mkilgore/avr-led-matrix/driver_board/led-matrix-headers.brd.png

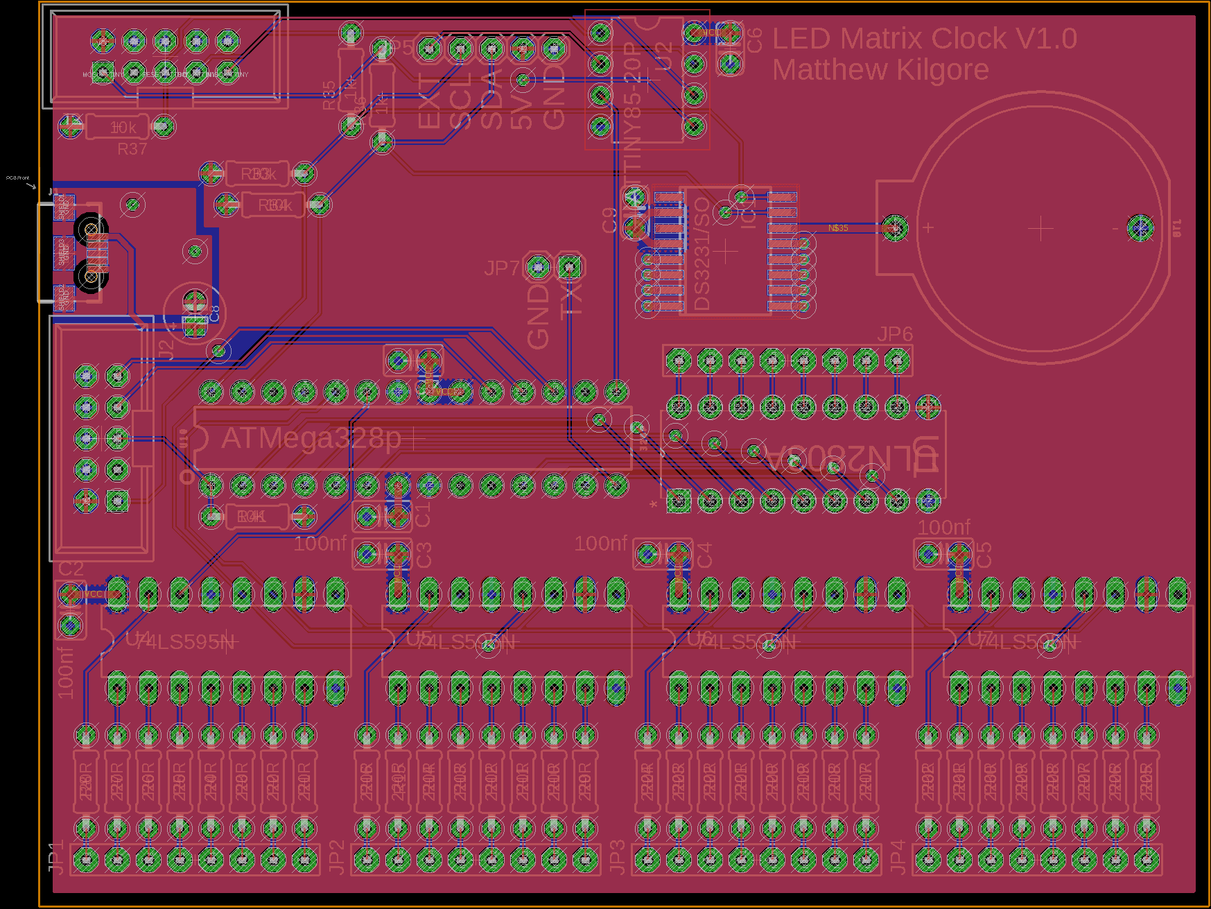
driver_board/led-matrix-headers.brd.png
