mkilgore/avr-led-matrix/driver_board/led-matrix-headers.sch.png

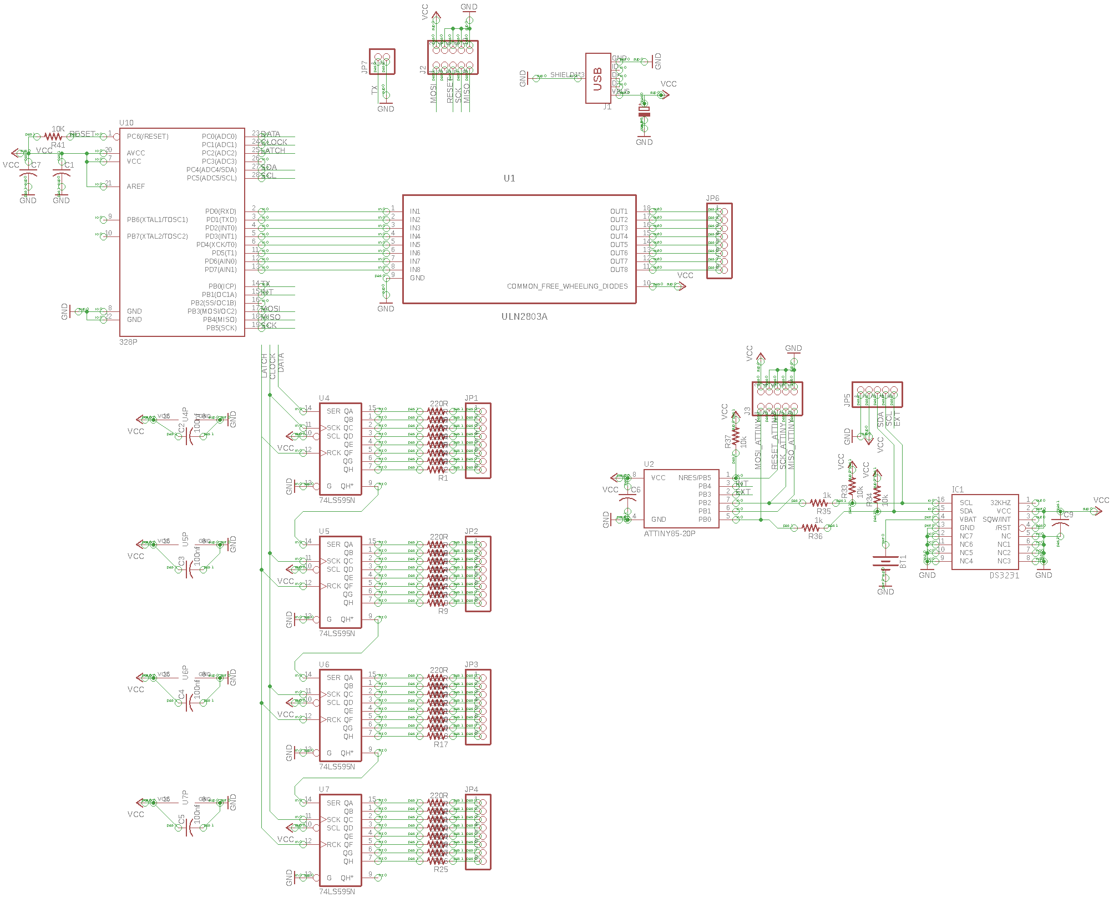
driver_board/led-matrix-headers.sch.png
