mkilgore/avr-led-matrix/driver_board/led-matrix-headers.brd

## EAGLE design driver_board/led-matrix-headers.brd (2018-10-06)

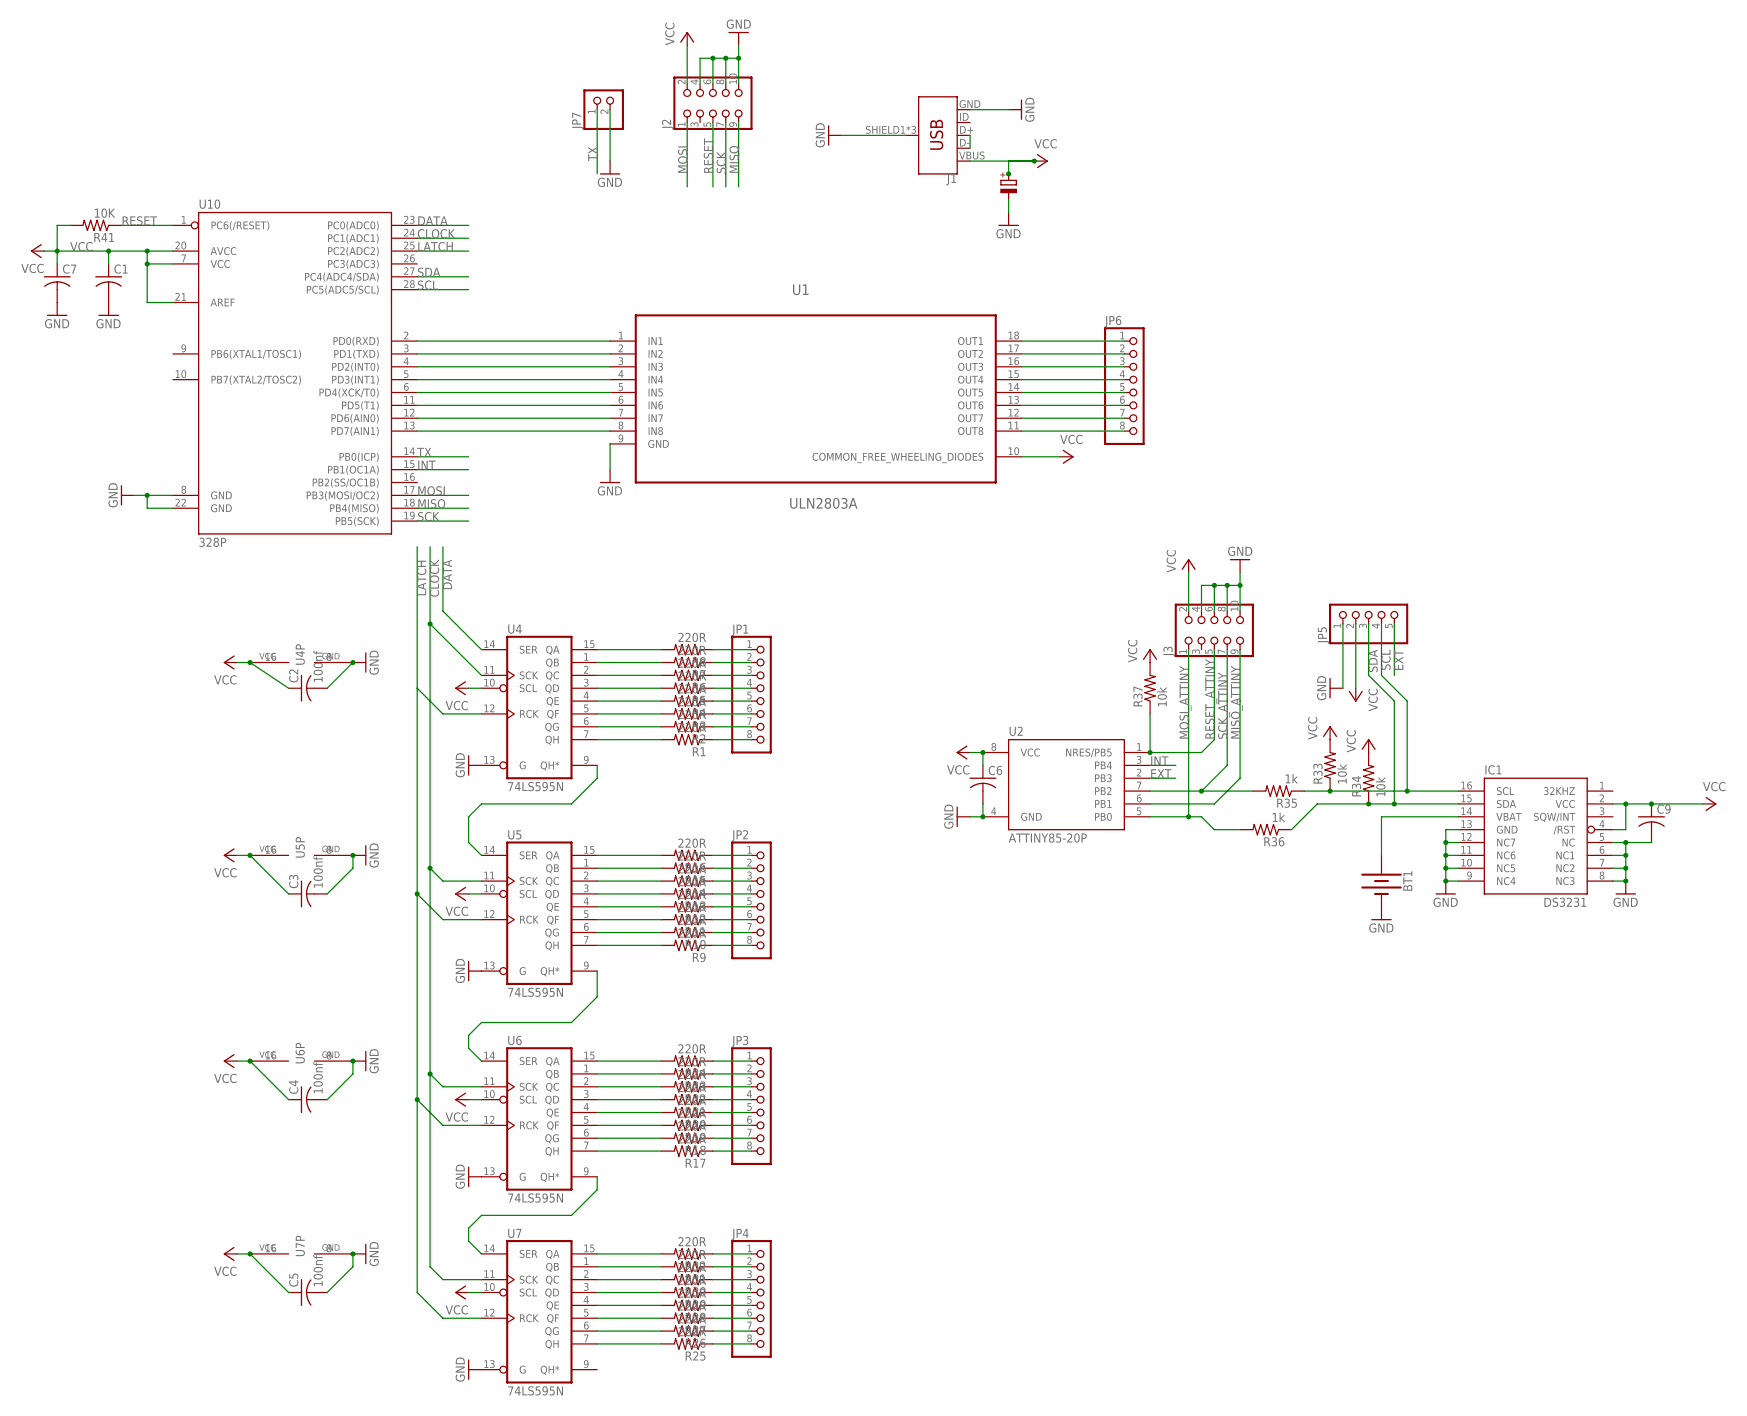
[picture p3: schematic led-matrix-headers.sch]

Parts:
BT1: BATTERY-20MM_PTH; BATTCOM_20MM_PTH
C1, C7: C-US025-025X050; C025-025X050
C2, C3, C4, C5: 100nf; C025-025X050
C6, C9: C-US025-024X044; C025-024X044
C8: 10U/35V; E2-5
IC1: DS3231/SO; SO16W
J1: USB_MICRO-B_FEMALE-SMT; USB-B-MICRO-SMD
J2, J3: CON_HEADER_2X05-PTH+SHROUDED_A; PINSHRD_PTH_2X05
JP1, JP2, JP3, JP4, JP6: PINHD-1X8BIG; 1X08-BIG
JP5: PINHD-1X5/OCT; 1X05/OCT
JP7: PINHD-1X02_2.54-S; 1X02-S
R1, R2, R3, R4, R5, R6, R7, R8, R9, R10, R11, R12, R13, R14, R15, R16, R17, R18, R19, R20, R21, R22, R23, R24, R25, R26, R27, R28, R29, R30, R31, R32: 220R; 0204/7
R33, R34, R37: 10k; 0204/7
R35, R36: 1k; 0204/7
R41: 10K; 0204/7
U1: ULN2803A; DIP254P762X393-18
U2: ATTINY85-20P; PDIP08_300MIL
U4, U5, U6, U7: 74LS595N; DIL16
U10: 328P; DIP28

Connections:
CLOCK: U4.11 (SCK), U5.11 (SCK), U6.11 (SCK), U7.11 (SCK), U10.24 (PC1(ADC1))
DATA: U4.14 (SER), U10.23 (PC0(ADC0))
EXT: JP5.5, U2.2 (PB3)
GND: BT1.2 (-), C1.2, C2.2, C3.2, C4.2, C5.2, C6.2, C7.2, C8.-, C9.2, IC1.5 (NC), IC1.6 (NC1), IC1.7 (NC2), IC1.8 (NC3), IC1.9 (NC4), IC1.10 (NC5), IC1.11 (NC6), IC1.12 (NC7), IC1.13 (GND), J1.GND, J1.SHIELD1 (SHIELD), J1.SHIELD2 (SHIELD), J1.SHIELD3 (SHIELD), J2.4, J2.6, J2.8, J2.10, J3.4, J3.6, J3.8, J3.10, JP5.1, JP7.2, U1.9 (GND), U2.4 (GND), U4.8 (GND), U4.13 (G), U5.8 (GND), U5.13 (G), U6.8 (GND), U6.13 (G), U7.8 (GND), U7.13 (G), U10.8 (GND), U10.22 (GND)
INT: U2.3 (PB4), U10.15 (PB1(OC1A))
LATCH: U4.12 (RCK), U5.12 (RCK), U6.12 (RCK), U7.12 (RCK), U10.25 (PC2(ADC2))
MISO: J2.9, U10.18 (PB4(MISO))
MISO_ATTINY: J3.9, U2.6 (PB1)
MOSI: J2.1, U10.17 (PB3(MOSI/OC2))
MOSI_ATTINY: J3.1, R36.2, U2.5 (PB0)
unnamed: JP1.8, R1.1
unnamed: JP1.7, R2.1
unnamed: JP1.6, R3.1
unnamed: JP1.5, R4.1
unnamed: JP1.4, R5.1
unnamed: JP1.3, R6.1
unnamed: JP1.2, R7.1
unnamed: JP1.1, R8.1
unnamed: JP2.8, R9.1
unnamed: JP2.7, R10.1
unnamed: JP2.6, R11.1
unnamed: JP2.5, R12.1
unnamed: JP2.4, R13.1
unnamed: JP2.3, R14.1
unnamed: JP2.2, R15.1
unnamed: JP2.1, R16.1
unnamed: JP3.8, R17.1
unnamed: JP3.7, R18.1
unnamed: JP3.6, R19.1
unnamed: JP3.5, R20.1
unnamed: JP3.4, R21.1
unnamed: JP3.3, R22.1
unnamed: JP3.2, R23.1
unnamed: JP3.1, R24.1
unnamed: JP4.8, R25.1
unnamed: JP4.7, R26.1
unnamed: JP4.6, R27.1
unnamed: JP4.5, R28.1
unnamed: JP4.4, R29.1
unnamed: JP4.3, R30.1
unnamed: JP4.2, R31.1
unnamed: JP4.1, R32.1
unnamed: BT1.1 (+), IC1.14 (VBAT)
unnamed: JP6.1, U1.18 (OUT1)
unnamed: JP6.2, U1.17 (OUT2)
unnamed: JP6.3, U1.16 (OUT3)
unnamed: JP6.4, U1.15 (OUT4)
unnamed: JP6.5, U1.14 (OUT5)
unnamed: JP6.6, U1.13 (OUT6)
unnamed: JP6.7, U1.12 (OUT7)
unnamed: JP6.8, U1.11 (OUT8)
unnamed: R1.2, U4.7 (QH)
unnamed: R2.2, U4.6 (QG)
unnamed: R3.2, U4.5 (QF)
unnamed: R4.2, U4.4 (QE)
unnamed: R5.2, U4.3 (QD)
unnamed: R6.2, U4.2 (QC)
unnamed: R7.2, U4.1 (QB)
unnamed: R8.2, U4.15 (QA)
unnamed: R25.2, U7.7 (QH)
unnamed: R26.2, U7.6 (QG)
unnamed: R27.2, U7.5 (QF)
unnamed: R28.2, U7.4 (QE)
unnamed: R29.2, U7.3 (QD)
unnamed: R30.2, U7.2 (QC)
unnamed: R31.2, U7.1 (QB)
unnamed: R32.2, U7.15 (QA)
unnamed: R17.2, U6.7 (QH)
unnamed: R18.2, U6.6 (QG)
unnamed: R19.2, U6.5 (QF)
unnamed: R20.2, U6.4 (QE)
unnamed: R21.2, U6.3 (QD)
unnamed: R22.2, U6.2 (QC)
unnamed: R23.2, U6.1 (QB)
unnamed: R24.2, U6.15 (QA)
unnamed: R9.2, U5.7 (QH)
unnamed: R10.2, U5.6 (QG)
unnamed: R11.2, U5.5 (QF)
unnamed: R12.2, U5.4 (QE)
unnamed: R13.2, U5.3 (QD)
unnamed: R14.2, U5.2 (QC)
unnamed: R15.2, U5.1 (QB)
unnamed: R16.2, U5.15 (QA)
unnamed: U4.9 (QH*), U5.14 (SER)
unnamed: U5.9 (QH*), U6.14 (SER)
unnamed: U6.9 (QH*), U7.14 (SER)
unnamed: U1.1 (IN1), U10.2 (PD0(RXD))
unnamed: U1.2 (IN2), U10.3 (PD1(TXD))
unnamed: U1.3 (IN3), U10.4 (PD2(INT0))
unnamed: U1.4 (IN4), U10.5 (PD3(INT1))
unnamed: U1.5 (IN5), U10.6 (PD4(XCK/T0))
unnamed: U1.6 (IN6), U10.11 (PD5(T1))
unnamed: U1.7 (IN7), U10.12 (PD6(AIN0))
unnamed: U1.8 (IN8), U10.13 (PD7(AIN1))
RESET: J2.5, R41.1, U10.1 (PC6(/RESET))
RESET_ATTINY: J3.5, R37.1, U2.1 (NRES/PB5)
SCK: J2.7, U10.19 (PB5(SCK))
SCK_ATTINY: J3.7, R35.2, U2.7 (PB2)
SCL: IC1.16 (SCL), JP5.4, R33.1, R35.1, U10.28 (PC5(ADC5/SCL))
SDA: IC1.15 (SDA), JP5.3, R34.1, R36.1, U10.27 (PC4(ADC4/SDA))
TX: JP7.1, U10.14 (PB0(ICP))
USB-DATA: J1.D+, J1.D-
VCC: C1.1, C2.1, C3.1, C4.1, C5.1, C6.1, C7.1, C8.+, C9.1, IC1.2 (VCC), IC1.4 (/RST), J1.VBUS, J2.2, J3.2, JP5.2, R33.2, R34.2, R37.2, R41.2, U1.10 (COMMON_FREE_WHEELING_DIODES), U2.8 (VCC), U4.10 (SCL), U4.16 (VCC), U5.10 (SCL), U5.16 (VCC), U6.10 (SCL), U6.16 (VCC), U7.10 (SCL), U7.16 (VCC), U10.7 (VCC), U10.20 (AVCC), U10.21 (AREF)

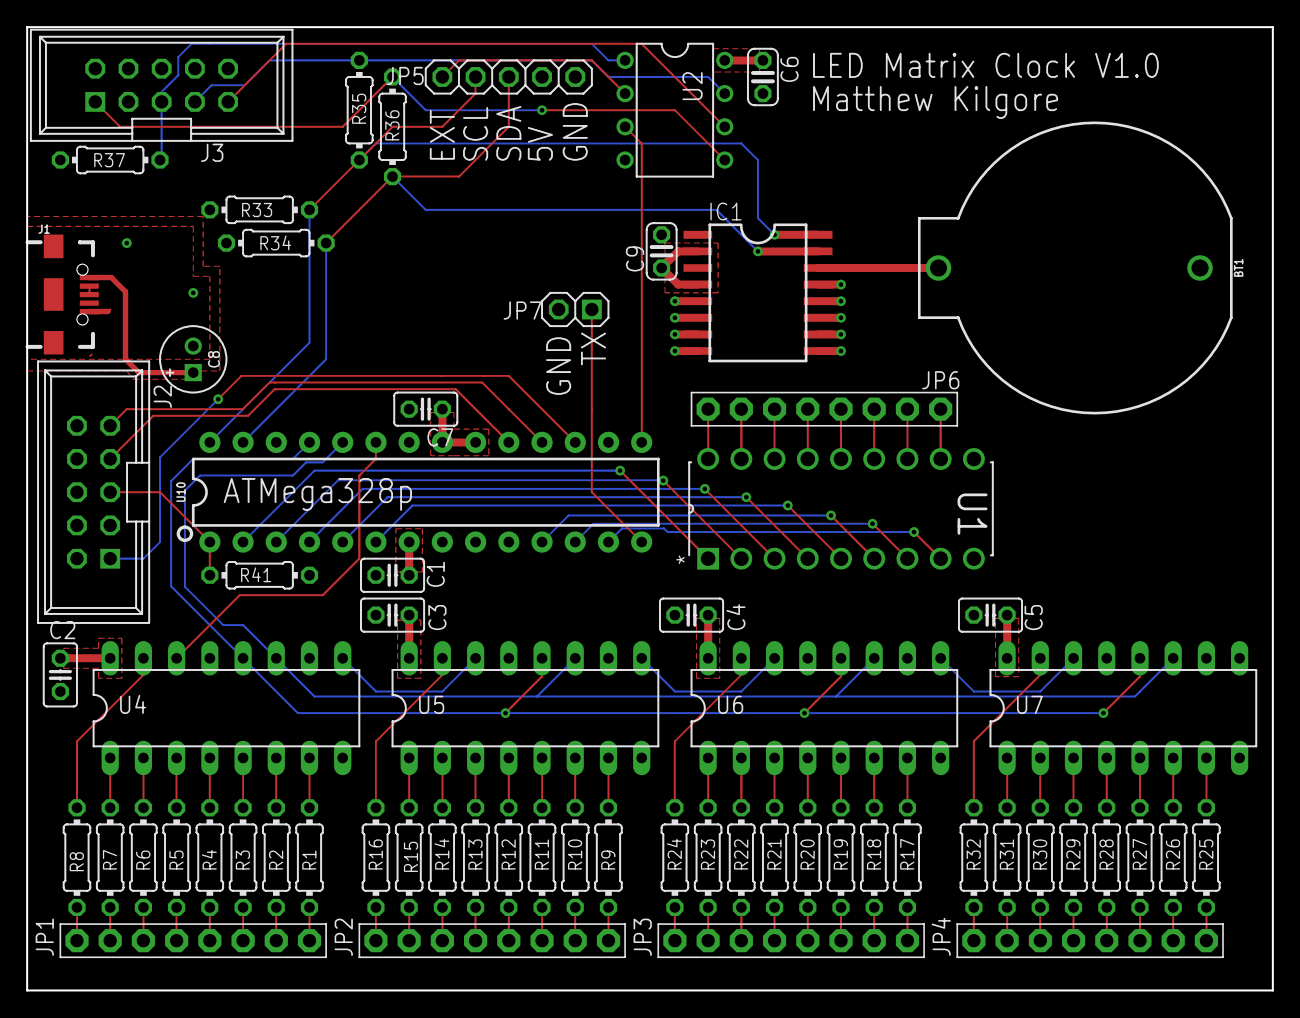
[picture p4: board led-matrix-headers.brd from above]

Board: 2 copper layers, 95.2 x 73.7 mm, 66 parts (0 on the bottom side), 103 nets.
