mkilgore/avr-led-matrix/led_board/led-matrix-headers-extender-board.brd

## EAGLE design led_board/led-matrix-headers-extender-board.brd (2018-10-06)

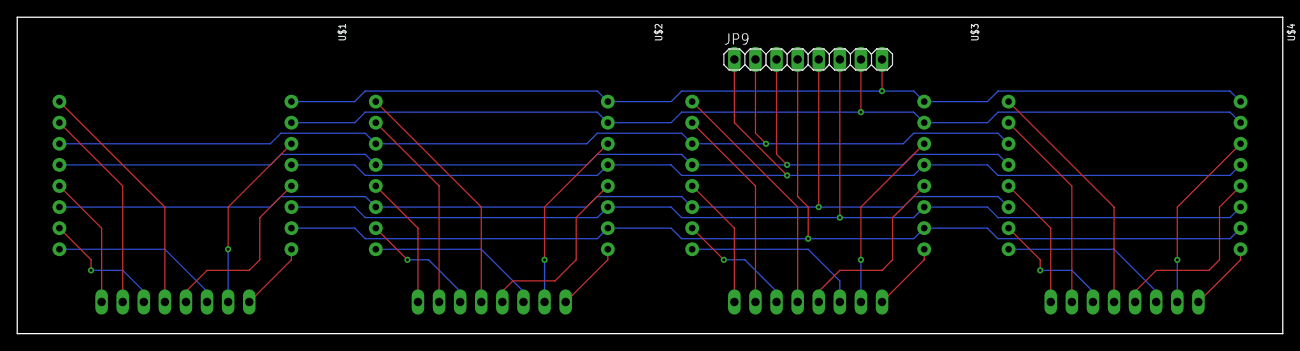
[picture p5: board led-matrix-headers-extender-board.brd from above]

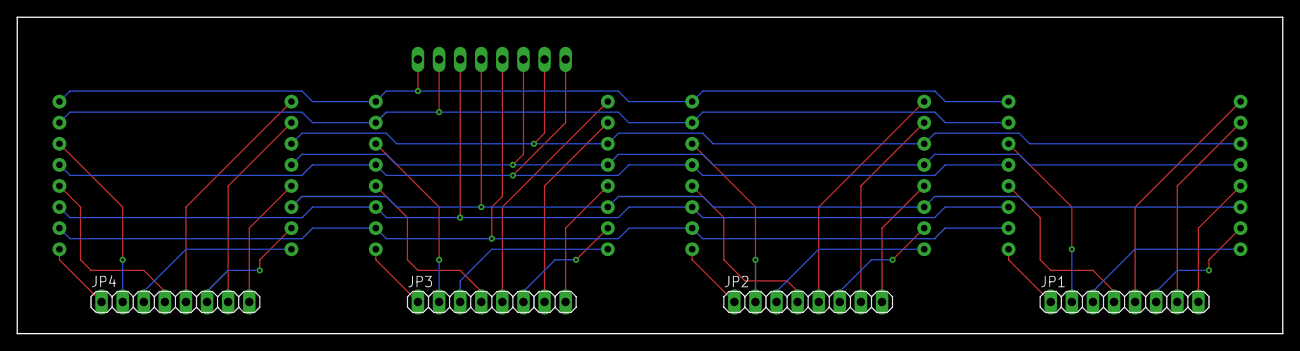
[picture p6: board led-matrix-headers-extender-board.brd from below]

Board: 2 copper layers, 152.4 x 38.1 mm, 9 parts (4 on the bottom side), 40 nets.

Parts:
JP1, JP2, JP3, JP4, JP9: 1X08
U$1, U$2, U$3, U$4: ANODEROW_TC15_11SRWA; SEGMENT_TC15-11SRWA

Connections:
unnamed: JP1.1, U$1.9
unnamed: JP1.2, U$1.14
unnamed: JP1.3, U$1.8
unnamed: JP1.4, U$1.12
unnamed: JP1.5, U$1.1
unnamed: JP1.6, U$1.7
unnamed: JP1.7, U$1.2
unnamed: JP1.8, U$1.5
unnamed: JP2.1, U$2.9
unnamed: JP2.2, U$2.14
unnamed: JP2.3, U$2.8
unnamed: JP2.4, U$2.12
unnamed: JP2.5, U$2.1
unnamed: JP2.6, U$2.7
unnamed: JP2.7, U$2.2
unnamed: JP2.8, U$2.5
unnamed: JP3.1, U$3.9
unnamed: JP3.2, U$3.14
unnamed: JP3.3, U$3.8
unnamed: JP3.4, U$3.12
unnamed: JP3.5, U$3.1
unnamed: JP3.6, U$3.7
unnamed: JP3.7, U$3.2
unnamed: JP3.8, U$3.5
unnamed: JP4.1, U$4.9
unnamed: JP4.2, U$4.14
unnamed: JP4.3, U$4.8
unnamed: JP4.4, U$4.12
unnamed: JP4.5, U$4.1
unnamed: JP4.6, U$4.7
unnamed: JP4.7, U$4.2
unnamed: JP4.8, U$4.5
unnamed: JP9.1, U$1.13, U$2.13, U$3.13, U$4.13
unnamed: JP9.2, U$1.3, U$2.3, U$3.3, U$4.3
unnamed: JP9.3, U$1.4, U$2.4, U$3.4, U$4.4
unnamed: JP9.4, U$1.10, U$2.10, U$3.10, U$4.10
unnamed: JP9.5, U$1.6, U$2.6, U$3.6, U$4.6
unnamed: JP9.6, U$1.11, U$2.11, U$3.11, U$4.11
unnamed: JP9.7, U$1.15, U$2.15, U$3.15, U$4.15
unnamed: JP9.8, U$1.16, U$2.16, U$3.16, U$4.16
