mkilgore/avr-led-matrix/(commit log)

2018-09-19 Initial code and schematic
    [led-matrix-headers.brd, led-matrix-headers.sch]
2018-10-06 Update ATMega code for actual PCB
2018-10-06 Small updates to LED Matrix driver board
    [led-matrix-headers.brd]
2018-10-06 Add eagle board for LED Matrix modules
    [led-matrix-headers-extender-board.brd, led-matrix-headers-separate.sch]
2018-10-06 atmega328_driver: Dim matrix a little bit
    The matrix is a bit too bright. If doing a rebuild the resistors should
    simply be changed for a higher value, however this change dims them via
    software by leaving them off for a short time rather then keeping them
    on almost constantly.
    [main.c]
